KocurMaros/MicroMouse/FEIStyle/includes/glossary.tex

\newacronym{ToF}{ToF}{Time of Flight}
\newacronym{PWM}{PWM}{Pulse width modulation}
