KocurMaros/MicroMouse/RiadenieProjektu/includes/glossary.tex

\newacronym{sw}{SW}{Star Wars}
\newacronym{hw}{HW}{Halo Wars}
\newacronym{cdma}{CDMA}{Code Division Multiple Access}
\newacronym{gsm}{GSM}{Global System for Mobile communication}
\newacronym{ToF}{ToF}{Time of Flight}
\newacronym{PWM}{PWM}{Pulse width modulation}
