KocurMaros/MicroMouse/FEIStyle/example_paper.pdf

### SLOVENSKÁ TECHNICKÁ UNIVERZITA V BRATISLAVE

### FAKULTA ELEKTROTECHNIKY A INFORMATIKY

## MICRO MOUSE

## SEMINÁRNA PRÁCA

2024 Bc. Eduard Zelenay Bc. Erik Móčik Bc. Filip Lobpreis Bc. Jakub Močarník Bc. Maroš Kocúr Bc. Matúš Machata Bc. Timotej Polc

### SLOVENSKÁ TECHNICKÁ UNIVERZITA V BRATISLAVE

### FAKULTA ELEKTROTECHNIKY A INFORMATIKY

## MICRO MOUSE

## SEMINÁRNA PRÁCA

Študijný program: | Aplikovaná informatika
Predmet: | I–TP – Tímový projekt
Prednášajúci: | doc. Ing. Andrej Babinec, PhD.
Bratislava 2024 | Bc. Eduard Zelenay Bc. Erik Móčik Bc. Filip
Lobpreis Bc. Jakub Močarník Bc. Maroš Kocúr Bc. Matúš Machata Bc. Timotej Polc

## Obsah

ii

# Zoznam obrázkov a tabuliek

iii

# Zoznam skratiek

PWM Pulse width modulation

ToF Time of Flight

iv

# Zoznam algoritmov

v

# Zoznam výpisov

vi

# Úvod

Práca spočíva v navrhnutí, zostrojení a programovaní mobilného robota, ktorý dokáže autonómne prechádzať bludiskom. Študenti musia dodržať maximálne povolené rozmery

pre súťaž a vybrať vhodné typy senzorov, ktoré umožnia vypočítať polohu na navigáciu

robota v bludisku.
Úlohy:
1. Navrhnutie a výroba dizajnu robota.
2. Výber vhodných motorov a snímačov (napr. ToF (Time of Flight), motorový ovlá-

dač, gyroskop).

3. Programovanie riadenia robota a implementácia spôsobu lokalizácie v bludisku.
4. Otestovanie funkčnosti zvoleného riešenia

# 1 Hardware

Z hárdverovej stránky sme potrebovali v tomto projekte vytvoriť dosku plošných spojov (PCB - Printed Circuit Boards) a návrh držiakov motorov, gyroskopu a kolies,

ktorých výroba prebiehala pomocou 3D tlače.

## 1.1 Model

Kolesá a ozubené koliesko pre hriadeľ motora boli vytlačené v 3D tlačiarni s resinovou

náplňou FabPro 1000 Resin Cartridge Tough BLK. Na obrázkoch ?? a ?? môžeme vidieť

návrhy ozubeného kolieska pre hriadeľ a kolesa.

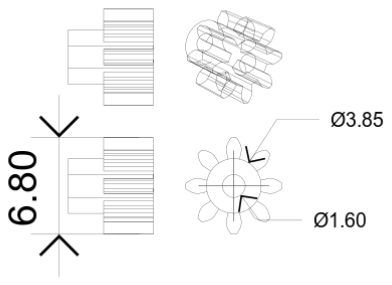
[picture p14: figure]

Obr. 1.1: UTechnický nákres prevodu motora

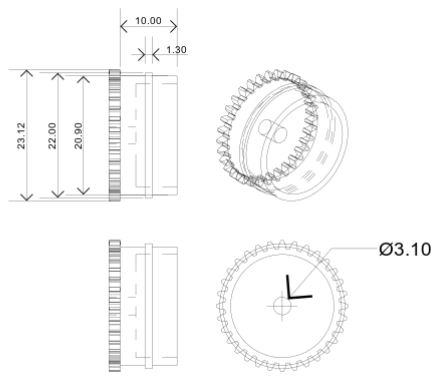
[picture p15: figure]

Obr. 1.2: Koleso s prevodovkou

## 1.2 Motory

Použité motory boli vybrané s ohľadom na ich výkonnosť a spoľahlivosť. Sú to jed-

nosmerné motory, vidieť ich môžeme na ?? a detaily o nich uvádzame nižšie:


Obr. 1.3: DC Mikromotor Faulhaber 1717T003SR

- Model: Faulhaber 1717 T
- Typ: 003 SR
- Max. točivý moment: 5.35 mNm
- Max. rýchlosť: 11000 rpm
- Odkaz na technický list: Technický list motora (https://www.faulhaber.com/fileadmin/Import/Media/EN_1717_SR_DFF.pdf)

## 1.3 Enkódery

Na monitorovanie polohy a otáčok motorov sme použili magnetické enkódery. Infor-

máciu o rotácií získavajú ako zmenu magnetického poľa. Enkóder obsahuje dva Hallove

články, ktoré merajú veľkosť magnetickej indukcie ako Hallovo napätie ako:

UH = hH

BIp
h

(1.1)

kde UH je Hallovo napätie, hH je Hallova konštanta, B je magnetická indukcia, Ip je po-

mocný prúd, h je hrúbka polovodičovej doštičky. Tieto Hallove články merajú magnetickú

indukciu v dvoch osiach na seba kolmých.

Enkóder obsahuje permanentný magnet pripevnený na jeho hriadeľ. Rotáciou hriadeľa

sa točí magnet, a teda aj smer magnetického poľa. Zmeny v oboch osiach sú prekonver-

tované cez AD prevodník na digitálne signály. Skrz trigonometrické funkcie je následne vypočítaný fázový posun medzi týmito signálmi. To je dôležité nielen kvôli výpočtu rotácie

hriadeľa, ale aj pre zistenie smeru rotácie.

Nižšie sú uvedené informácie o použitých enkóderoch ??:

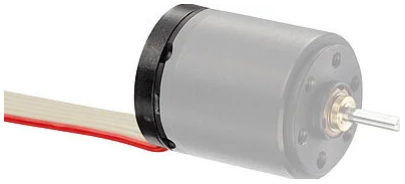
[picture p16: figure]

Obr. 1.4: Enkóder IEH2-4096

- Model: IEH2-4096
- Rozlíšenie: 4096
- Kanály: 2
- Odkaz na technický list: Technický list enkódera (https://www.faulhaber.com/fileadmin/Import/Media/EN_IEH2-4096_DFF.pdf)

## 1.4 Gyroskop

Na sledovanie orientácie a pohybu robota sme si zvolili MEMS gyroskop. Tie merajú

uhlovú rýchlosť prostredníctvom Coriolisovho efektu. Coriolisova sila je spôsobená inerciou

objektu v priamom pohybe, kolmo na smer pohybu objektu a jej výpočet je daný:

F⃗ = −2mΩ⃗
zx⃗v | (1.2)

MEMS Gyroskop obsahuje vybrujúce elementy na pružine. Keď sa gyroskop pohybuje

kapacitný senzor deteguje vibrácie, tie sa následne premenia na uhlové zrýchlenie.

Ďalej sú uvedené podrobnosti o použitom module ??:


Obr. 1.5: Gyroskop MPU9250

- Model: MPU9250
- Typ: Gyroskop, akcelerometer a magnetometer
- Komunikácia: I2C, SPI
- Odkaz na technický list: MPU9250 Technical Datasheet (https://www.invensense.com/products/motion-tracking/9-axis/mpu-9250/)

## 1.5 Laserový diaľkomer

Ako vzdialenostný senzor sme zvolili Time-of-Flight (doba trvania letu) laserový me-

rací modul poskytujúci presné meranie vzdialenosti bez ohľadu na farbu alebo odrazivosť

cieľa. Time-of-Flight senzory fungujú na báze merania času letu laserového lúča vyslaného

zo senzora, k objektu a naspäť. Vzdialenosť je z nameraného času vypočítaná podľa vzorca

na ??:

d =

c · t
2

(1.3)

kde d je vypočítaná vzdialenosť, c je rýchlosť svetla a t je doba letu lúča.

Modul môžeme vidieť na obrázku ??. Nižšie sú uvedené parametre senzora.

- Model: VL53L1X


Obr. 1.6: Vzdialenostný senzor VL53L1X

- Maximálna vzdialenosť: 400cm
- Frekvencia merania: nastaviteľná až do 50Hz
- Zorné pole: 27°
- Komunikácia: I2C
- Odkaz na technický list: Technický list laserového diaľkomera (https://www.st.com/resource/en/datasheet/vl53l1x.pdf)

Na meranie vzdialenosti sme využili štyri takéto moduly pripevnené na dosku vyosené

relatívne od dopredného smeru myši o 45° a 10°.

## 1.6 PCB

### 1.6.1 Komponenty

- Senzory ToF (VL53L1X): Prepojenie s ESP32 cez I2C rozhranie.
- Gyroskop s akcelerometrom (MPU9250): Prepojenie s ESP32 cez I2C rozhra-

nie.

- Driver na motor (TB6612FNG): Umiestnený blízko motorov, posiela PWM

signály motorom.

- MCU (ESP32): Centrálny riadiaci prvok PCB.
- Step-up menič na 5V: Zabezpečenie stabilných 5V pre logické obvody a enkodéry.
- Logic shifter: Prekladanie signálov medzi 3,3V a 5V úrovňami.

- Ochrana batérie: Meranie napätia batérie a prúdové ochrany.
- Batéria (Li-ion 1000mAh): Umiestnená na PCB s prístupnými napájacími ko-

nektormi a ochrannými obvodmi.

### 1.6.2 Proces tvorby PCB

- Návrh schémy

Vytvorili sme detailný návrh elektrickej schémy s prepojeniami všetkých komponen-

tov, pričom sme zabezpečili správne napäťové úrovne a prepojenia medzi jednotli-

vými časťami.

- Rozmiestnenie komponentov

Strategicky sme umiestnili všetky komponenty na PCB tak, aby boli minimalizované

rušenia a zohľadnené fyzické rozmery a montážne obmedzenia.

- Vedenie ciest
Navrhnli sme cesty (trasy) pre prepojenie komponentov, s dôrazom na minimalizáciu

kríženia ciest a optimalizáciu pre rušenie (napr. použitie samostatných zemných a

napájacích rovín).

- Napájanie a ochrany
Implementovali sme obvody na stabilizáciu napätia (3,3V a 5V), ochrany batérie, a

zabezpečili, aby boli všetky komponenty správne napájané a chránené.

Taktiež sme museli myslieť na nasledovné:

- Udržanie minimálnej dĺžky kritických signálových trás (I2C, PWM).
- Oddelenie silových a signálových ciest na PCB, aby sa minimalizovalo rušenie.
- Zabezpečenie dostatočnej kapacity a filtrácie na napájacích cestách.
- Implementácia ochranných obvodov pre batériu a citlivé komponenty.

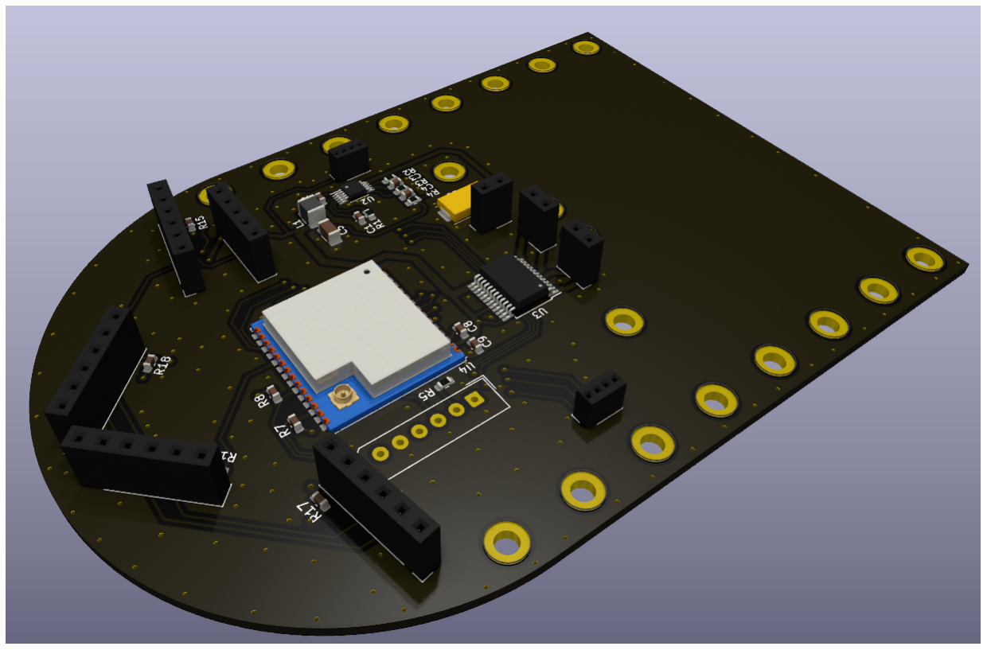
[picture p17: figure]

Obr. 1.7: Návrh PCB dosky použitej vo finálnej verzii.

## 1.7 CAD

Pri návrhu ako aj pri postupnom iterovaní sme zohľadňovali mnohé aspekty spojené

s procesom pri prototypizovaní. Mnohé verzie boli navrhnuté rovnako no v konečnom

dôsledku nám ich proces tlače zmenil a museli sme sa s tým vysporiadať, pretože presnosť

pri našom návrhu zohrávala kľúčovú úlohu. Pri tlači sme používali dva typy 3D tlače,

klasickú FDA no aj živicovú SLA tlač.

- 3D návrh kolies

Kolesá pre Micro Mouse boli navrhnuté na základe existujúcich modelov, ktoré po-

skytli osvedčený základ pre dizajn. Použitie osvedčených modelov umožnilo urýchliť návrhový proces a zaručilo, že výsledné kolesá budú spĺňať požadované špecifikácie.

- Výber modelu

Pre návrh kolies sme vybrali modely, ktoré sú už overené v praxi. Tento prístup

minimalizoval riziko návrhových chýb a zabezpečil, že kolesá budú mať vhodné

mechanické vlastnosti a správne rozmery.

- Návrh gumy na kolesá

Gumy na kolesá boli použité z existujúceho modelu, čo zabezpečilo optimálnu trak-

ciu a odolnosť. Tento krok eliminoval potrebu vlastného návrhu gumy a umožnil

nám sústrediť sa na integráciu kolies do celkového návrhu Micro Mouse.

- 3D návrh úchytov

Pre návrh úchytov sme využili iteratívny proces, ktorý umožnil presné prispôsobenie

vzdialeností kolies a ich optimálne umiestnenie na Micro Mouse.

- Iteratívny proces návrhu

Návrh úchytov prebiehal v niekoľkých iteráciách, pričom sme upravovali vzdialenosti

kolies a ich polohu, aby sme dosiahli najlepšiu možnú stabilitu a pohyblivosť Micro

Mouse. Tento proces zahŕňal testovanie rôznych konfigurácií a úpravou návrhu na

základe výsledkov týchto testov.

- Optimalizácia vzdialeností

Upravovanie vzdialeností kolies bolo kľúčové pre dosiahnutie optimálnej manévrova-

teľnosti. Iteratívne úpravy umožnili presné doladenie návrhu, čo viedlo k zlepšeniu

celkového výkonu Micro Mouse.

Návrh a výroba 3D komponentov pre Micro Mouse zahŕňala použitie existujúcich

modelov kolies a gumy, ako aj iteratívny návrh úchytov. Tento prístup umožnil efektívne

vytvorenie funkčných a spoľahlivých komponentov, ktoré prispievajú k optimálnemu vý-

konu Micro Mouse.


Obr. 1.8: Konečná verzia návrhu všetkých komponentov vyrábaných pomocou 3D tlače

usporiadaných na PCB.

# 2 Software

Na písanie kódu sme použili prostredie esp_idf verzie 4.4.7, ktoré sme vytvorili za pomoci ich repozitára [espGithub].

Postup na inicializáciu ESP IDF a následné spustenie projektu je nasledovný:

1. Stiahnutie ESP IDF z repozitára [espGithub] (My sme použili verziu 4.4.7).
2. Spustenie príkazu ./install.sh esp32 pre Linux. Tento príkaz stiahne a nainštaluje

všetky potrebne závislosti.

3. Exportovanie súboru . ./export.sh pre Linux. Tento príkaz nastaví všetky potrebne

premenne prostredia.

4. Zmeniť aktuálny adresár na náš projekt.
5. Spustiť príkaz idf.py build pre kompiláciu projektu.
6. Spustiť príkaz idf.py -P <PORT_NR> flash pre nahratie binárneho súboru do ESP32.

Pre tuto operáciu je potrebne mať pripojený počítač a misku cez UART.

7. Spustiť príkaz idf.py monitor pre sledovanie výstupu z ESP32.

Alternatívne spustenie je možné pomocou platformy Visual Studio Code s nainštalovaným rozšírením ESP-IDF [espIDF].

## 2.1 Senzory

### 2.1.1 VL53L1X

Pre snímanie vzdialenosti bola vytvorená knižnica na kalibráciu a vyčítavanie dát

zo senzora VL53L1X. Komunikácia prebieha prostredníctvom komunikačného protokolu

I

2C. Knižnica je nadstavbou nad voľne dostupným rozhraním od STMicroelectronics.

Na obrázku ?? je zobrazený princíp fungovania senzora využívajúceho metódu Time-of-

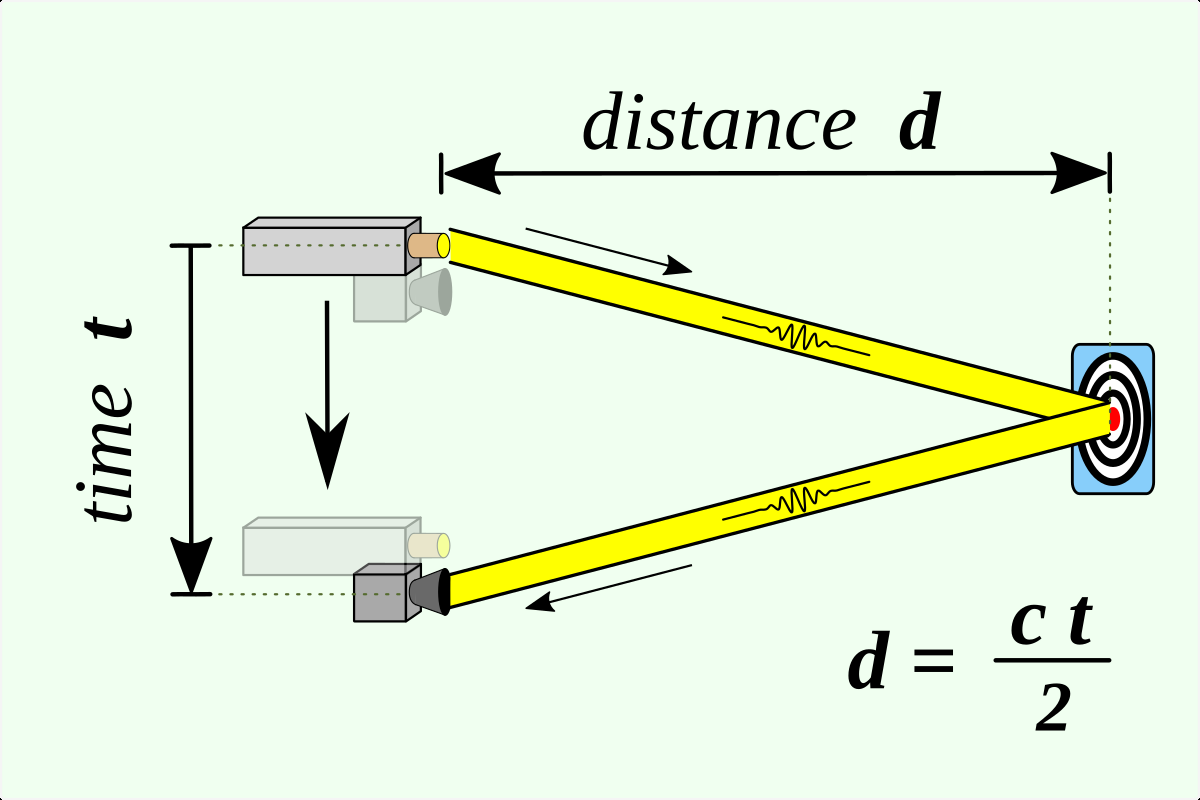
[picture p18: figure]

Obr. 2.1: Základný princíp ToF

Flight (ToF) pre meranie vzdialenosti. Zariadenie emituje svetelný signál, ktorý sa odrazi

od objektu a vráti späť k senzoru.

### 2.1.2 MPU9250

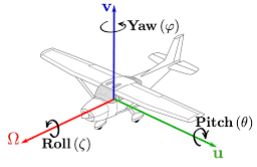
[picture p19: figure]

Obr. 2.2: Gyroskop s akcelerometrom MPU9250

V našom projekte sme použili senzor MPU9250, ktorý je trojosovým akcelerometrom

a gyroskopom. Tento senzor nám umožňuje získavať presné údaje o orientácii mikromyši v trojrozmernom priestore. Kľúčovou súčasťou spracovania dát z tohto senzoru je výpočet

Eulerových uhlov – roll, pitch a yaw. Tieto údaje sú neoceniteľné pre stabilizáciu a presné

navigačné manévre mikromyši, poskytujúc tak lepší prehľad o jej aktuálnom náklone a

orientácii.

### 2.1.3 IEH2-4096

V rámci nášho projektu sme implementovali impulzové čítače s inkrementálnymi en-

kodérmi IEH2-4096, ktoré sú pripevnené na motory. Tieto enkodéry generujú signál v

podobe elektrických impulzov v závislosti od uhlového pohybu motorov. Pre naše účely sme nastavili systém tak, aby generoval prerušenie po každej 1/8 otáčke motora.

Každý "tick"nám indikuje 1/8 otáčky motora, a pomocou softvéru potom prepočíta-

vame tieto hodnoty na požadované metrické jednotky (napríklad stupne alebo radiány).

Tento mechanizmus nám umožňuje presne sledovať a regulovať pohyb mikromyši, čo je

kritické pre presné navigačné a kontrolné úlohy v autonómnych aplikáciách.

## 2.2 Odometria

Pri počítaní polohy robota bola použítá odometria. Použili sme na to inkrementálny

enkóder ??, ktorý je pripojený na motor ??. Z enkóderov si získame aktuálnu polohu

robota cez základný vzťah:

∆xt = xt−1 + ∆st

- cos(ϕt−1 + ∆ϕt) | (2.1)

∆yt = yt−1 + ∆st

- sin(ϕt−1 + ∆ϕt) | (2.2)

,kde:

- ∆xt a ∆yt sú zmeny pozície robota v osiach x a y v čase t,
- xt−1 a yt−1 sú predchádzajúce pozície robota v osiach x a y,
- ∆st
je vzdialenosť, ktorú robot prešiel od posledného merania,
- ϕt−1 je predchádzajúci uhol orientácie robota,
- ∆ϕt
je zmena uhla orientácie robota získaná z gyroskopu.

Pre lepšie pochopenie odometrie a jej presnosti je dôležité zvážiť aj potenciálne chyby

z enkóderov a gyroskopu, ako aj spôsoby ich korekcie v softvérovom riešení robota.

## 2.3 PID regulátor motorov

Do motorov posielame ako akčný zásah signál PWM (Pulse width modulation). Tento

signál môže nadobúdať hodnoty od 0 po 1023. Zároveň musíme myslieť aj na prepäťovú

ochranu. Keď pošleme do motorov veľké zrýchlenie, tak sa stane, že sa program na čipe

zresetuje.

Aby sme ošetrili tieto situácie, sme pridali rozbehový člen v podobe rampového sig-

nálu, ktorý zabezpečí postupné zmeny žiadanej hodnoty namiesto skokových zmien. Na

riadenie motorov sme implementovali PID regulátor s Antiwindupom. Jeho obmedzenie je

nastavené zdola na 0 a zhora na 1023. Toto obmedzenie zdola je nastavené na 0 kvôli imple-

mentácii nastavenia smeru otáčania motorov. V prostredí ESP musíme dopredu nastaviť

smer otáčania motorov. Po jeho nastavení sa všetky hodnoty posielajú ako unsigned. Teda

ak by sme mu poslali zápornú hodnotu, tak by sa motor rozbehol nastaveným smerom.

Antiwindup zapojenie maximálnu rýchlosť obmedzuje na 1023.

Pre jednoduchosť ovládania sme nastavili regulátor tak, aby vstupná žiadaná hodnota

bol v milimetroch za sekundu. Regulátor si túto hodnotu prepočíta na PWM signál, ktorý pošle motorom. Spätné väzby sa získavajú z enkóderov a dopočítavajú sa na milimetre

za sekundu. Tieto hodnoty sa taktiež prepočítajú na PWM signál. Prepočet z milimetrov

za sekundu na PWM signál je závislý uskutočňovaný nasledujúcim výpočtom:

mmps = dπ IMPt IMPpri∆t
(2.3)

Rovnica ?? obsahuje parametre:

- d - Priemer kolesa,
- IMPt - Aktuálne impulzy z enkóderu,
- IMPpr - Impulzy z enkóderu za jednu otáčku (per rotation),
- i - Pomer prevodovky motora. Na našich motoroch je to prevod 32:8,
- ∆t - Časový interval od posledného merania

PWM =

mmps
MW SIMPpr

(2.4)

Rovnica ?? obsahuje parametre:

- mmps - Rýchlosť robota v milimetroch za sekundu vypocitanej v rovnici ??,
- MWS - Maximálna rýchlosť otacania kolies,
- IMPpr - Impulzy z enkóderu za jednu otáčku (per rotation).

## 2.4 Riadiaci algoritmus

Na obrázku ?? je znázornený tokový diagram, ktorý predstavuje algoritmus na roz-

hodovanie o pohybe v priestore. Tento diagram obsahuje niekoľko krokov a rozhodnutí:

1. Štart - Začiatočný bod algoritmu.
2. Slepá ulica? - Rozhodovací krok, kde sa algoritmus pýta, či sa pred myškou na-

chádza slepá ulica.

- Ak áno, nasleduje krok Otoč sa, čo znamená zmenu smeru o 180 stupňov.
- Ak nie, pokračuje ďalším rozhodnutím.
3. Je ľavá stena bližšie ako pravá? - Ďalšie rozhodovacie kritérium zvažujúce re-

latívne pozície stien.

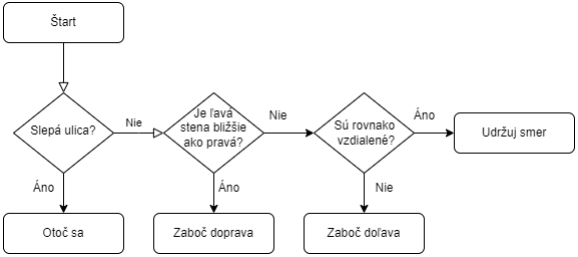
[picture p20: figure]

Obr. 2.3: UML diagram logiky algoritmu

- Ak áno, nasleduje krok Zaboč doprava.
- Ak nie, presmeruje sa na ďalší rozhodovací bod.
4. Sú rovnako vzdialené? - Rozhoduje, či sú obidve steny rovnako vzdialené od

myšky.

- Ak áno, nasleduje krok Zaboč doľava.
- Ak nie, vykoná sa krok Udržuj smer, čo znamená pokračovanie v súčasnom

smere bez zmeny.

## 2.5 Upresnenie implementacie

Miska funguje na principe reaktivnej navigacie. V pristupe kombinujeme 2 metody.

Jedna je Braitenbergov pohon typu fear a PID regulator. Nase zariadnie pouziva 4 ToF

snimace:

- ToF1 - Snimac na lavej strane snimajuci smer vpred,
- ToF2 - Snimac na lavej strane snimajuci smer valavo pod uhlom 45 stupnov, tak

aby snimali dalsiu bunku,

- ToF3 - Snimac na prave strane snimajuci smer vpravo pod uhlom 45 stupnov, tak

aby snimali dalsiu bunku,

- ToF4 - Snimac na prave strane snimajuci smer vpred

Kedze bludisko je splet uliciek, o ktorych nevieme kadial smeruju tak nam snimace

mozu vratit rozne velke hodnoty. Z tohto dovodu nam mozu snimace vracat velek aj

male hodnoty. Aby sme spravili z nepredvidatelneho prostredia predvidatelne, tak sme

vzdialenosti snimacov 1 a 4 obmedzili na 20 centimetrov. Toto obmedzenie vychadzalo z

exprimentalnych merani v bludisku o velkosti uliciek 22.5 centimetra.

Algoritmus funguje nasledovne:

1. Zistenie rozdielu ToF1 a ToF4.
2. Dopocitanie akcneho zasahu na z PID zo zisteneho rozdielu.
3. Tocimesa na zaklade znamienka akcneho zasahu.
4. Otacanie sa ovplyvnuje na zaklade vzdialenosti ToF2 a ToF3.

## 2.6 UDP Komunikácia

### 2.6.1 Client

Klientom v našom prípade je ESP32, ktorý sa používa v PCB mikromyši. Toto za-

riadenie je zodpovedné za zber údajov o stave a správaní mikromyši a ich odosielanie na

server. Komunikácia s serverom prebieha prostredníctvom UDP protokolu, čo umožňuje

rýchly a efektívny prenos dát.

### 2.6.2 Server

Na strane servera sme použili vývojové prostredie Qt Creator s programovacím ja-

zykom C++ na implementáciu serverovej časti, ktorá prijíma dáta od klienta. Server je integrovaný s mini HMI (Human-Machine Interface) aplikáciou, ktorá umožňuje real-time

vizualizáciu dát prostredníctvom grafov a poskytuje užívateľské rozhranie pre sledovanie

a ladenie správania mikromyši.

HMI aplikácia je kľúčovým nástrojom pre efektívne diagnostikovanie a optimalizáciu

výkonu autonómnej mikromyši. ??

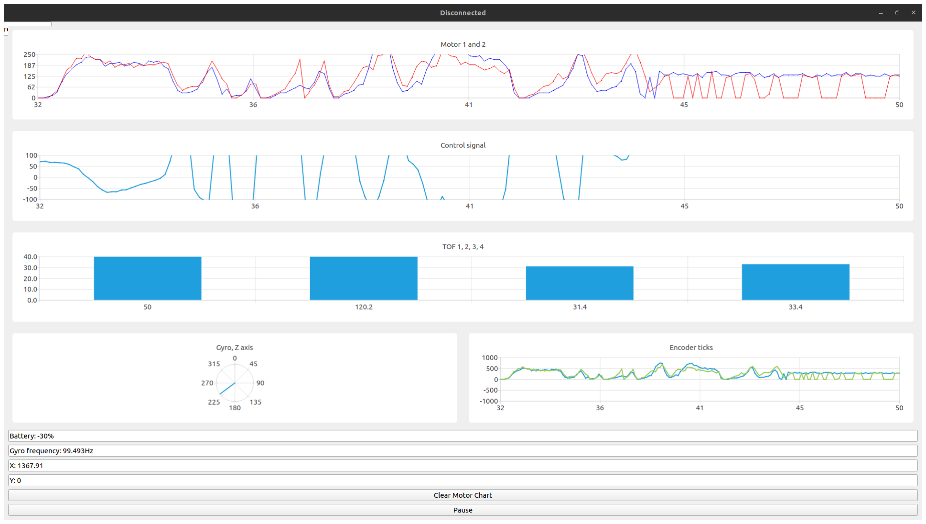
[picture p21: figure]

Obr. 2.4: Používateľské rozhranie HMI aplikácie

# Záver

Na tomto zadaní sme sa naučili komunikovať a riešiť problémy ako tím.

Na záver môžeme konštatovať, že úlohy projektu MicroMouse boli úspešne splnené.

Plne sme využili potenciál celého tímu a maximálne sme sa snažili využiť všetky nami

zadefinované senzory. Optimalizáciou softvéru sme dosiahli, že robot dokázal prechádzať

úzkymi uličkami bez nárazov, čo výrazne prispelo k jeho celkovej efektivite a presnosti.

Počas projektu sme však narazili na problémy s pohonom, konkrétne so zablokova-

ním prevodovky, čo spôsobovalo nepresnosť v odometrii. Tieto problémy nám znemožnili

využitie odometrie na lokalizáciu robota.

V druhej verzii projektu sa zameriame na odstránenie týchto nedostatkov, aby sme

mohli plne využiť odometriu na presnú lokalizáciu robota. A taktiež by sme chceli upraviť

hardware, keďže máme k dispozícii presne rozmery senzorov a motorov a odladili sme

chyby týkajúce sa hardware na prvej verzii, čo by mohlo pomôcť robotu pohybovať sa

plynulejšie a pomôže to taktiež s váhou robota. Na nasledujúce hardwarove úpravy by

sme vyladili regulátory a robot sa bude správať rovnako ako v prvej verzii.

Veríme, že tieto skúsenosti a získané poznatky nám umožnia pokračovať v ďalšom

vývoji a dosiahnuť ešte lepšie výsledky v budúcich verziách MicroMouse.

# Prílohy

# A Štruktúra elektronického nosiča

# B Algoritmus

# C Výpis sublime
