KocurMaros/MicroMouse/Datasheets/angle_tofs.png

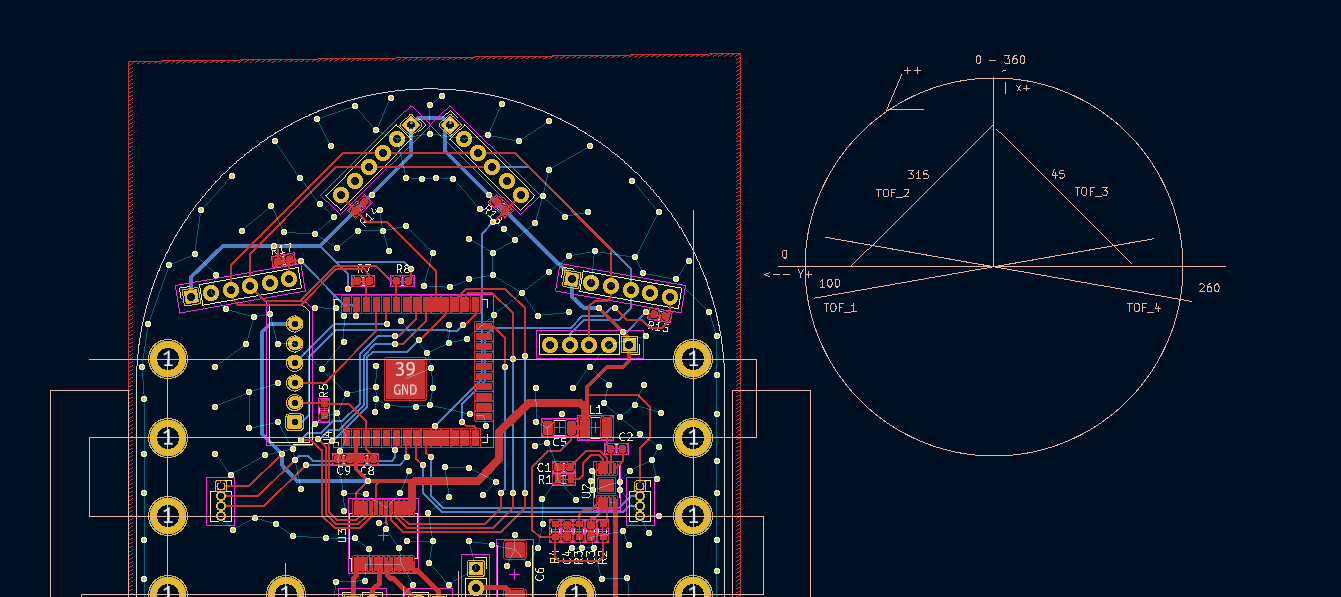
Datasheets/angle_tofs.png
