KocurMaros/MicroMouse/Datasheets/dist_from_center.png

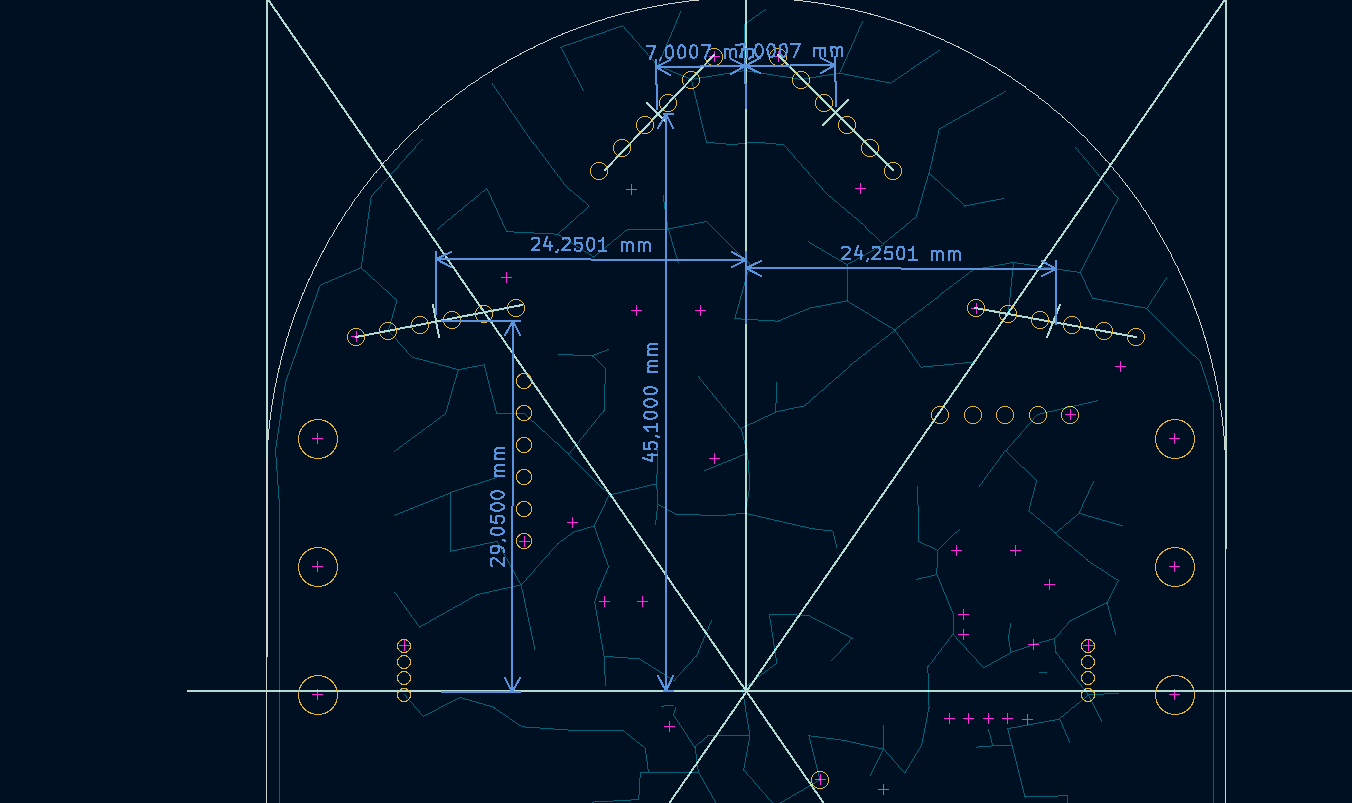
Datasheets/dist_from_center.png
