KocurMaros/MicroMouse/3D/main_board_v2.step

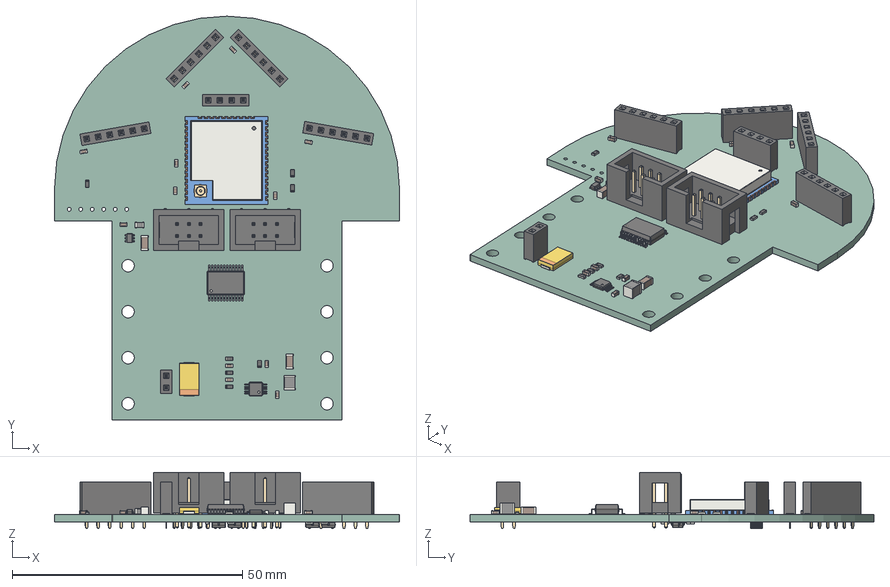
[picture p24: CAD file, 2024-11-08]
3D/main_board_v2.step
75.0 x 87.8 x 12.2 mm
PinSocket_1x06_P254mm_Vertical x 4
R_0603_1608Metric x 15
C_0603_1608Metric x 12
CP_EIA_7343_15_Kemet_W
PinSocket_1x02_P254mm_Vertical
C_1206_3216Metric x 2
ESP32-WROOM-32U
MSOP_10_1EP_3x3mm_P05mm
IDC_Header_2x03_P254mm_Vertical x 2
SOT_363_SC_70_6
L_1210_3225Metric
PinSocket_1x04_P254mm_Vertical
L_0805_2012Metric
SSOP_24_53x82mm_P065mm
SOT_23 x 4
main_board_PCB
