KocurMaros/MicroMouse/3D/1717T_SR.stp

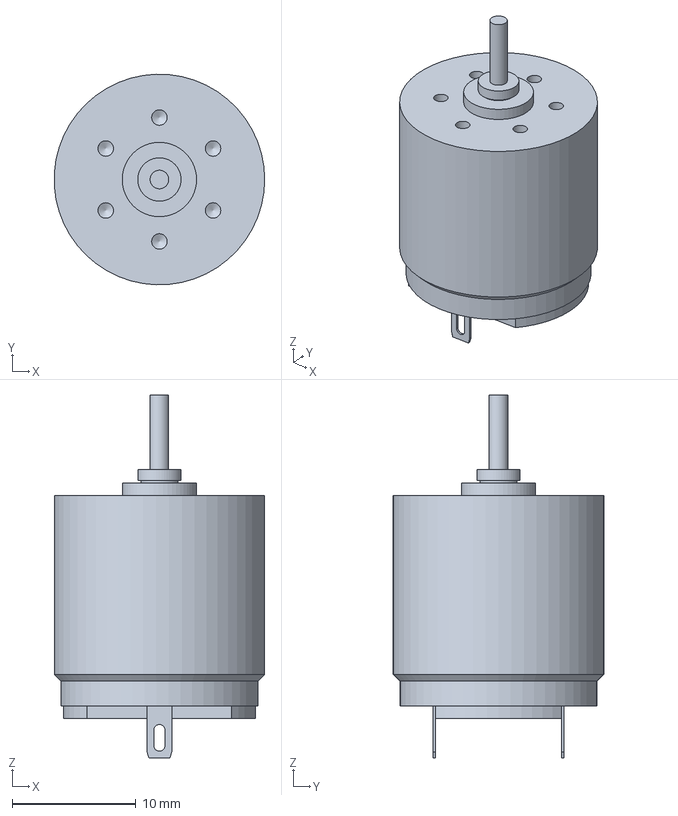
[picture p26: CAD file, 2024-05-28]
3D/1717T_SR.stp
17.0 x 17.0 x 29.3 mm
