KocurMaros/MicroMouse/3D/Side_wall_L.stp

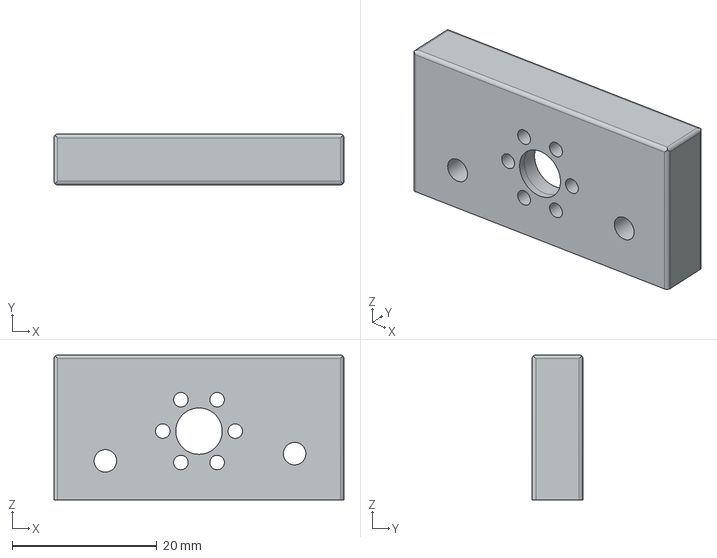
[picture p27: CAD file, 2024-05-28]
3D/Side_wall_L.stp
40.0 x 7.00 x 20.0 mm
