KocurMaros/MicroMouse/3D/Mount.stp

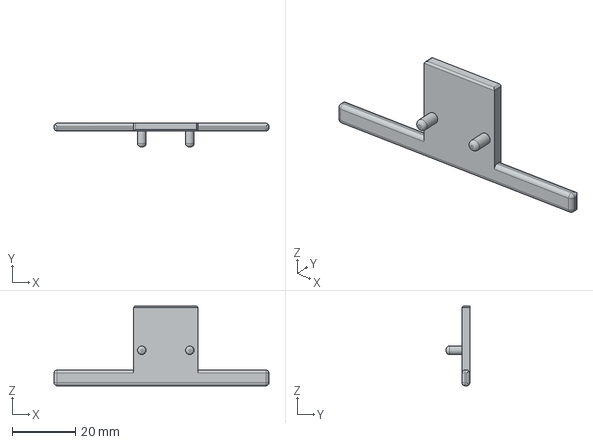
[picture p28: CAD file, 2024-05-28]
3D/Mount.stp
68.0 x 7.50 x 25.2 mm
