KocurMaros/MicroMouse/3D/motor_gear2.stp

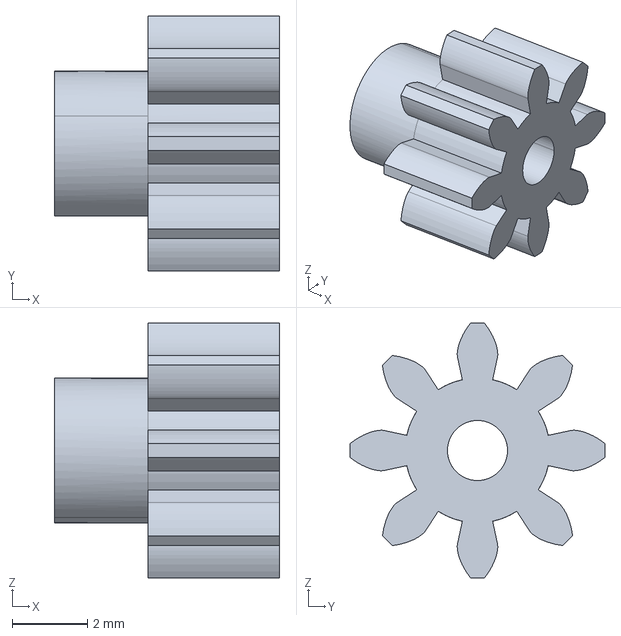
[picture p29: CAD file, 2024-05-28]
3D/motor_gear2.stp
6.00 x 6.79 x 6.79 mm
