KocurMaros/MicroMouse/3D/wheel_w_gear_2.stp

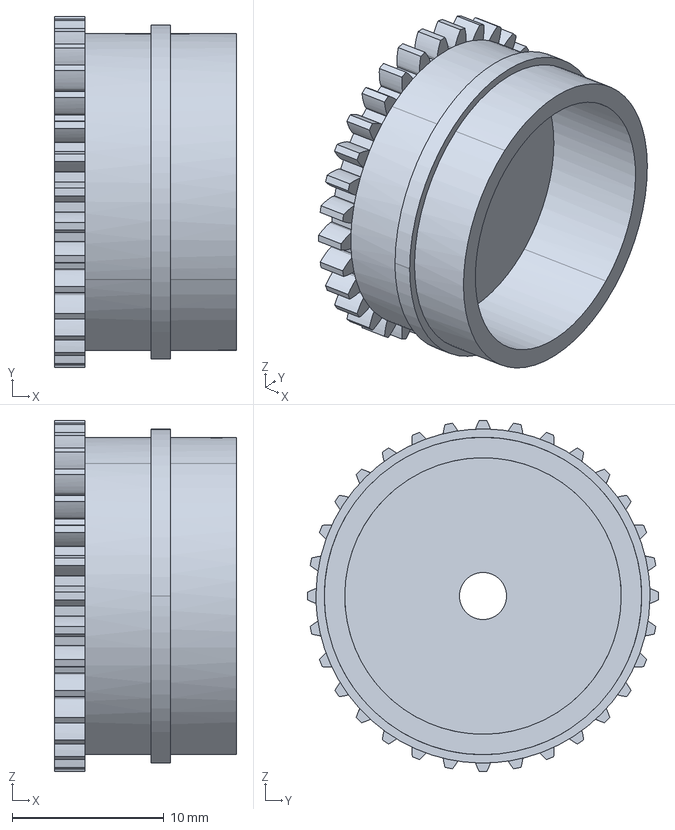
[picture p30: CAD file, 2024-05-28]
3D/wheel_w_gear_2.stp
12.0 x 23.1 x 23.1 mm
