KocurMaros/MicroMouse/3D/wheel_without_gear.stp

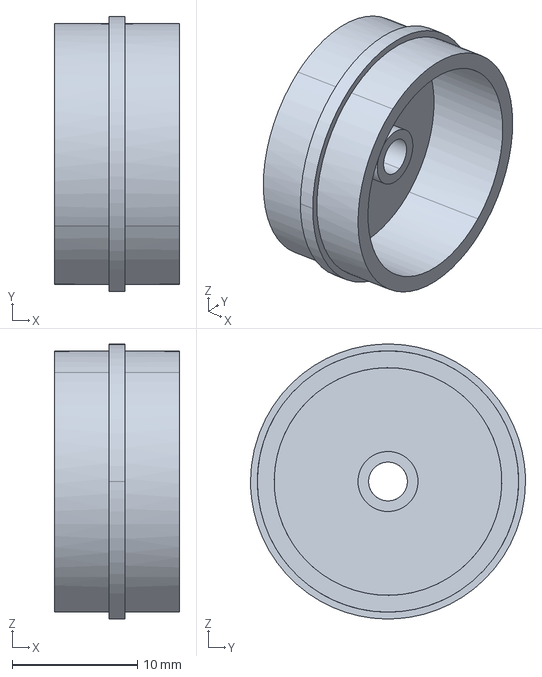
[picture p31: CAD file, 2024-05-28]
3D/wheel_without_gear.stp
10.0 x 22.0 x 22.0 mm
