KocurMaros/MicroMouse/3D/motor_gear.obj

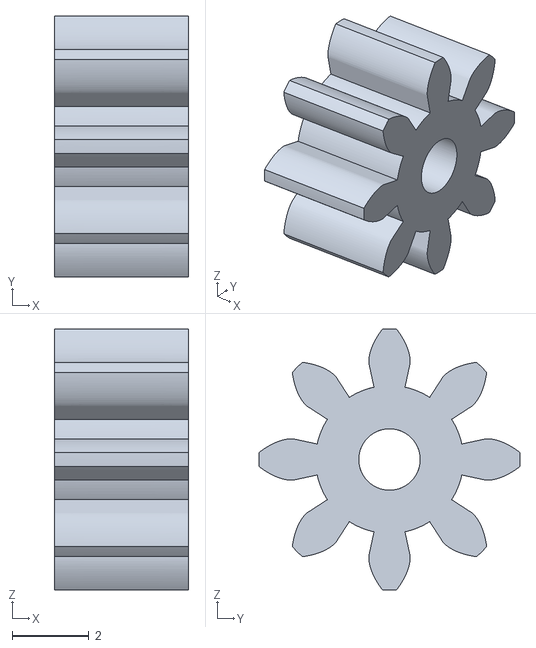
[picture p32: CAD file, 2024-03-11]
3D/motor_gear.obj
3.50 x 6.80 x 6.80
