KocurMaros/MicroMouse/3D/wheel_w_gear.obj

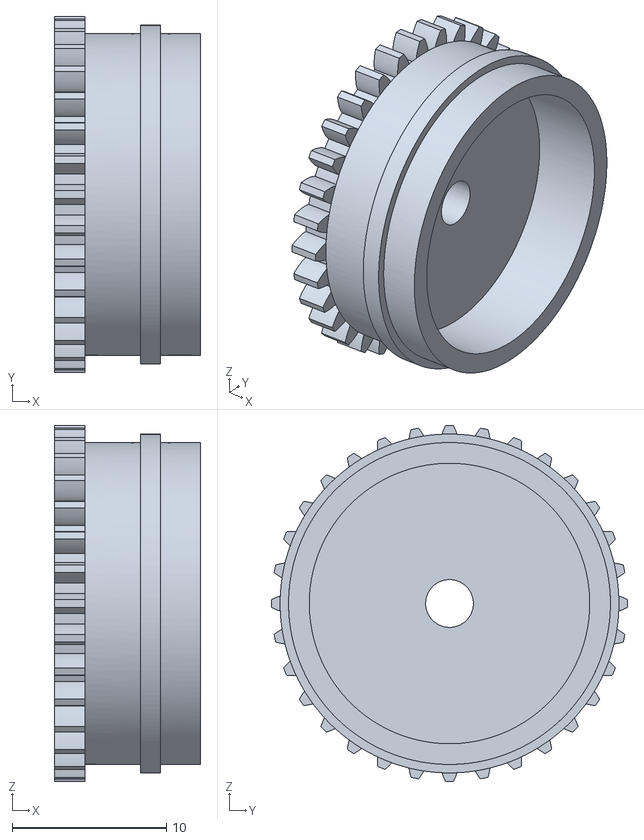
[picture p33: CAD file, 2024-03-11]
3D/wheel_w_gear.obj
9.50 x 23.1 x 23.1
