KocurMaros/MicroMouse/3D/main_board.step

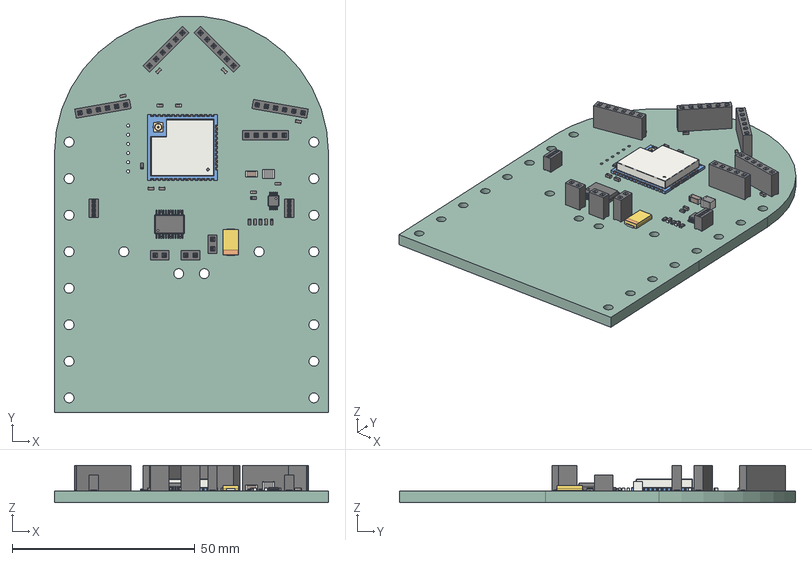
[picture p34: CAD file, 2024-02-29, an earlier design]
3D/main_board.step
75.0 x 108.4 x 10.2 mm
PinSocket_1x06_P254mm_Vertical x 4
R_0603_1608Metric x 5
C_0603_1608Metric x 12
CP_EIA_7343_15_Kemet_W
PinSocket_1x02_P254mm_Vertical x 3
ESP32-WROOM-32U
MSOP_10_1EP_3x3mm_P05mm
PinSocket_1x04_P127mm_Vertical x 2
L_1210_3225Metric
SSOP_24_53x82mm_P065mm
PinSocket_1x05_P254mm_Vertical
C_1206_3216Metric
main_board_PCB
