KocurMaros/MicroMouse/(list of files, cad)

Other CAD files:
3D/Side_wall_R.stp
3D/Mount.stl
3D/Side_wall_L.stl
3D/Side_wall_R.stl
3D/main_board.stl
