KocurMaros/MicroMouse/RiadenieProjektu/tutorial.pdf

Tutorial k písaniu zavere ´ | cnˇ ych pr ´ | ac pre ´ | sablonu ˇ

# FEIstyle v 1.2c

22. jula 2014 ´
1 Pouzitie ˇ | sablony ˇ
Sablona je defaultne nastaven ˇ | a pre p ´ | ísanie zavere ´ | cnˇ ych pre pre FEI STU v Bratislave ´
pre odbor Aplikovana informatika. ´

## 2 Príklad pouzitia ˇ sablony ˇ

\documentclass[bp]{FEIstyle}

\FEIauthor{Michal Liziˇ ciar ˇ | }
\FEItitle{Anonymizacia internetov ´ | eho pr ´ | ístupu}
\FEItitleEn{Anonymization of internet access} \FEIregNr{FEI-5382-5982}
\FEIsupervisor{Mgr. Ing. Matu´s J ˇ okay, PhD. ´ | }

\begin{document}
\FEIpdfInfo
\FEIcover
\FEItitlePage
\FEIassignment{includes/assignment.jpeg}
\FEIabstract{includes/abstract}{anonymizacia, identifik ´ | acia pou ´ | zˇívatel’a, zasuvn ´ | y mo- ´
dul, Mozilla Firefox, internet}
\FEIabstractEn{includes/abstractEN}{anonymization, identification of user, plugin, Mozilla Firefox, internet}
\FEIdeclaration{includes/declaration}
\FEIthanks{}
\FEIcontent
\FEIlistOfFiguresAndTables \FEIlistOfAbbreviationsAndSymbols{includes/AbbreviationsAndSymbols} \FEIlistOfAlgorithms
\FEIintroduction{includes/introduction}
\FEIcore{includes/core}

1

\FEIconclusion{includes/conclusion} \FEIbibliography{includes/bibliography}{FEIstyle} \FEIlistOfAppendix
\FEIappendix{Strukt ˇ | ura elektronick ´ | eho nosi ´ | caˇ }{includes/prilohaA}
\FEIappendix{Algoritmus}{includes/prilohaB}
\end{document}

## 3 Moznosti ˇ sablony ˇ

Argumenty sablony: ˇ

bp - bakalarska pr ´ | aca ´
dp – diplomova pr ´ | aca ´

article – stˇ yl article (default) ´
book – stˇ yl book ´
en – sablona p ˇ | ísana v anglickom jazyku ´
m - (muz) sklonovanie textu v slovenskom vyhl ˇ | asen ´ | í
z - (zena) sklonovanie textu v slovenskom vyhl ˇ | asen ´ | í
(default: dvojtvar (a))

windows1250 - kodovanie textu windows1250 (default) ´ utf8 - kodovanie textu utf8 ´

4 Globalne premenn ´ | é

\FEIauthor{meno}
- definuje autora zavere ´ | cnej pr ˇ | ace ´

\FEIschool{nazov skoly}
\FEIschoolEn{nazov skoly (anglicky)}
- definuje nazov ´ | skoly ˇ
default: Slovenska technick ´ | a univerzita v Bratislave ´
default: Slovak University of Technology in Bratislava

\FEItitle{nazov prace}
\FEItitleEn{nazov prace (anglicky)}
- definuje nazov pr ´ ace ´

\FEIfaculty{nazov fakulty} \FEIfacultyEn{nazov fakulty(anglicky)}

2

- definuje nazov fakulty ´
default: Fakulta elektrotechniky a informatiky
default: Faculty of Electrical Engineering and Information Technology

\FEIregNr{registracnˇ é cˇíslo}
- definuje registracne ˇ cˇíslo prace ´

\FEIdate{day}{month}{year}
- definuje datum vytvorenia pr ´ | ace ´
default: aktualny d ´ | atum ´
\FEIstudyProgramme{nazov ´ | studijn ˇ | eho programu ´ | }
\FEIstudyProgrammeEn{nazov ´ | studijn ˇ | eho programu(anglicky) ´ | }
- definuje nazov ´ | studijn ˇ | eho programu ´
default: Aplikovana informatika ´
default: Applied Informatics
\FEIstudyFieldNumber{cˇíslo studijn ˇ | eho odboru ´ | }
- definuje cˇíslo studijn ˇ | eho odboru ´
default: 2511
\FEIstudyField{nazov ´ | studijn ˇ | eho odboru ´ | }
\FEIstudyFieldEn{nazov ´ | studijn ˇ | eho odboru(anglicky) ´ | }
- definuje nazov ´ | studijn ˇ | eho odboru ´
default: 9.2.9 Aplikovana informatika ´
default: 9.2.9 Applied Informatics
\FEItrainingWorkplace{nazov ´ | skoliaceho pracoviska ˇ | }
\FEItrainingWorkplaceEn{nazov ´ | skoliaceho pracoviskan ˇ | azov ´ | skoliaceho pracoviska ˇ | }
- definuje nazov ´ | skoliaceho pracoviska ˇ
default: Ustav informatiky a matematiky ´
default: Institute of Computer Science and Mathematics

\FEIsupervisor{meno}
- definuje meno veduceho z ´ | avere ´ | cnej pr ˇ | ace ´

\FEIconsultant{meno}
- definuje meno konzultanta

\FEIplace{mesto}
- definuje miesto písania prace ´ default: Bratislava

3

## 5 Funkcie sablony ˇ

\FEIcover
- vytvorí obal zavere ´ | cnej pr ˇ | ace ´

\FEItitlePage
- vytvorí titulnu stranu z ´ | avere ´ | cnej pr ˇ | ace ´

\FEIdeclaration{[subor]}
- vytvorí vyhlasanie autora pr ´ | ace. Pri anglickom jazyku je povinn ´ | y extern ´ | y s ´ ubor. ´
default: defaultny text v slovenskom jazyku, mo ´ | znost ˇ | ’ zmenit’ text

\FEIthanks{[subor]}
- vytvorí pod’akovanie. Pri anglickom jazyku je povinny extern ´ | y s ´ ubor. ´
default: defaultny text v slovenskom jazyku, mo ´ | znost ˇ | ’ zmenit’ text

\FEIassignment{subor}
- vlozˇí obrazok zadania zavere ´ | cnej pr ˇ | ace ´

\FEIabstract{subor}{klucove slova}
\FEIabstractEn{subor}{klucove slova}
- vlozˇí abstrak zavere ´ | cnej pr ˇ | ace. Vstupom je extern ´ | y s ´ ubor a kl ´ | ’ućov ˇ e slov ´ | a abstraktu. ´

\FEIcontent
- vlozˇí obsah

\FEIlistOfTables
- vlozˇí zoznam tabuliek

\FEIlistOfFigures
- vlozˇí zoznam obrazkov ´

\FEIlistOfFiguresAndTables
- vlozˇí zoznam obrazkov a tabuliek ´

\FEIlistOfAbbreviations{subor}
- vlozˇí zoznam skratiek z externeho s ´ uboru ´

\FEIlistOfSymbols{subor}
- vlozˇí zoznam symbolov z externeho s ´ uboru ´

\FEIlistOfAbbreviationsAndSymbols{subor}
- vlozˇí zoznam skratiek a symbolov z externeho s ´ uboru ´

\FEIlistOfAlgorithms
- vlozˇí zoznam algoritmov

4

\FEIintroduction{subor}
- vlozˇí uvod z extern ´ | eho s ´ | uboru ´

\FEIcore{subor}
- vlozˇí jadro prace z extern ´ | eho s ´ | uboru ´

\FEIconclusion{subor}
- vlozˇí zaver pr ´ | ace z extern ´ | eho s ´ | uboru ´

\FEIresume{subor}
- vlozˇí resume z extern ´ | eho s ´ | uboru (pri pr ´ | acach p ´ | ísanych po anglicky) ´

\FEIbibliography{subor}{subor stylu}
- vlozˇí literaturu z extern ´ | eho s ´ | uboru, ´ | stˇ yl pre ´ | sablonu je definovan ˇ | y vo FEIstyle.bst ´

\FEIlistOfAppendix
- vlozˇí zoznam príloh

\FEIappendix{nazov}{subor}
- vlozˇí prílohu do prace. Nazov: text je uveden ´ | y v obsahu a v nadpise pr ´ | ílohy. Subor ´
definuje cestu k externemu s ´ | uboru. ´

\FEIpdfInfo
- vyplní hlavicku PDF dokumentu z preddefinovan ˇ | ych ´ | udajov (n ´ | azov pr ´ | ace, autor, ´
skola, fakulta) ˇ

5
