KocurMaros/MicroMouse/(threads)

Thread 1 (2024-02-28):

Sensor GY-VL53L0X I2C

KocurMaros, 2024-02-28:
Write driver for sensor GY-VL53L0X I2C, to read distance from 4 sensors.
SDA = GPIO21
SCL = GPIO22
xSHUT1 = GPIO23
xSHUT2 = GPIO05
xSHUT3 = GPIO25
xSHUT4 = GPIO12

Closed 2024-04-19.

Thread 2 (2024-02-28):

Motor driver and regulator

KocurMaros, 2024-02-28:
Write driver for motor driver and create speed controller.
Motor driver: TB6612FNG
MotorA:
Direction of rotation (Log.1/0):
    - GPIO18 CW
    - GPIO19 CCW
Speed(PWM):
    - GPIO17
MotorB:
Direction of rotation (Log.1/0):
    - GPIO16 CW
    - GPIO04 CCW
Speed(PWM):
    - GPIO02
Incremental encoder (interrupts):
MotorA:
    - GPIO34 ChannelA
    - GPIO33 ChannelB
MotorB:
    - GPIO35 ChannelA
    - GPIO32 ChannelB
https://www.faulhaber.com/fileadmin/Import/Media/EN_1717_SR_DFF.pdf
https://www.faulhaber.com/fileadmin/Import/Media/EN_IEH2-4096_DFF.pdf

Fildo7525, 2024-05-13:
Review the code to be merged

Closed 2024-05-30.

Thread 4 (2024-02-28):

3D model for motor base

KocurMaros, 2024-02-28:
CAD 3D model for holding motor and wheels according to PCB design.
Front wheels slightly lower than rear.
Try as light as possible

Thread 6 (2024-02-28):

3D CAD wheels

KocurMaros, 2024-02-28:
create 3D model of disk with gearbox [1:4~6], with used tires.

Probably:
https://www.peckamodel.sk/ksm538-pn-racing-mini-z-ks-m-compound-rcp-low-profile-slick-8-5mm-tire-medium-2pc
