KocurMaros/MicroMouse/code/esp_code/components/driver_tof/core/inc/vl53l1_api_core.h

/*
* Copyright (c) 2017, STMicroelectronics - All Rights Reserved
*
* This file is part of VL53L1 Core and is dual licensed,
* either 'STMicroelectronics
* Proprietary license'
* or 'BSD 3-clause "New" or "Revised" License' , at your option.
*
********************************************************************************
*
* 'STMicroelectronics Proprietary license'
*
********************************************************************************
*
* License terms: STMicroelectronics Proprietary in accordance with licensing
* terms at www.st.com/sla0081
*
* STMicroelectronics confidential
* Reproduction and Communication of this document is strictly prohibited unless
* specifically authorized in writing by STMicroelectronics.
*
*
********************************************************************************
*
* Alternatively, VL53L1 Core may be distributed under the terms of
* 'BSD 3-clause "New" or "Revised" License', in which case the following
* provisions apply instead of the ones mentioned above :
*
********************************************************************************
*
* License terms: BSD 3-clause "New" or "Revised" License.
*
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
* 3. Neither the name of the copyright holder nor the names of its contributors
* may be used to endorse or promote products derived from this software
* without specific prior written permission.
*
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
*
********************************************************************************
*
*/

/**
 * @file  vl53l1_api_core.h
 *
 * @brief EwokPlus25 low level API function definitions
 */

#ifndef _VL53L1_API_CORE_H_
#define _VL53L1_API_CORE_H_

#include "vl53l1_platform.h"

#ifdef __cplusplus
extern "C" {
#endif


/**
 * @brief Get LL Driver version information
 *
 * @param[in]   Dev       : Device handle
 * @param[out]  pversion  : pointer to VL53L1_ll_version_t
 *
 * @return  VL53L1_ERROR_NONE     Success
 */

#ifdef VL53L1_DEBUG
VL53L1_Error VL53L1_get_version(VL53L1_DEV Dev, VL53L1_ll_version_t *pversion);

/**
 * @brief Gets Device Firmware version
 *
 * @param[in]   Dev           : Device handle
 * @param[out]  pfw_version   : pointer to uint16_t FW version
 *
 * @return  VL53L1_ERROR_NONE     Success
 */

VL53L1_Error VL53L1_get_device_firmware_version(VL53L1_DEV Dev, uint16_t *pfw_version);
#endif


/**
 * @brief Initialises pdev structure and optionally read the
 *        part to part information form he device G02 registers
 *
 * Important: VL53L1_platform_initialise() *must* called before calling
 * this function
 *
 * @param[in]   Dev           : Device handle
 * @param[out]  read_p2p_data : if > 0 then reads and caches P2P data
 *
 * @return  VL53L1_ERROR_NONE     Success
 */

VL53L1_Error VL53L1_data_init(VL53L1_DEV Dev, uint8_t read_p2p_data);


/**
 * @brief  For C-API one time initialization only reads device
 *         G02 registers containing data copied from NVM
 *
 *  Contains the key NVM data e.g identification info
 *  fast oscillator freq, max trim and laser safety info
 *
 *  Function all only be called after the device has finished booting
 *
 * @param[in]   Dev           : Device handle
 *
 * @return  VL53L1_ERROR_NONE     Success
 */

VL53L1_Error VL53L1_read_p2p_data(VL53L1_DEV Dev);


/**
 * @brief Performs device software reset and then waits for  the firmware
 *        to finish booting
 *
 * @param[in]   Dev           : Device handle
 *
 * @return  VL53L1_ERROR_NONE     Success
 * @return  "Other error code"    See ::VL53L1_Error
 */

VL53L1_Error VL53L1_software_reset(VL53L1_DEV Dev);


/**
 * @brief  Sets the customer part to part data
 *
 * Important: does **not** apply the settings to the device.
 * Updates the following structures in the device structure
 *
 * Just an internal memcpy to
 *
 *
 * @param[in]   Dev             : Device handle
 * @param[in]   pcal_data       : pointer to VL53L1_calibration_data_t
 *
 * @return  VL53L1_ERROR_NONE     Success
 * @return  "Other error code"    See ::VL53L1_Error
 */

VL53L1_Error VL53L1_set_part_to_part_data(VL53L1_DEV Dev, VL53L1_calibration_data_t *pcal_data);


/**
 * @brief  Gets the customer part to part data
 *
 * Just an internal memory copy
 *
 * @param[in]   Dev             : Device handle
 * @param[out]  pcal_data       : pointer to VL53L1_calibration_data_t
 *
 *
 * @return  VL53L1_ERROR_NONE     Success
 * @return  "Other error code"    See ::VL53L1_Error
 */

VL53L1_Error VL53L1_get_part_to_part_data(VL53L1_DEV Dev, VL53L1_calibration_data_t *pcal_data);


/**
 * @brief  Gets the tuning parm part to part data
 *
 * Just an internal copy
 *
 * @param[in]   Dev             : Device handle
 * @param[out]  ptun_data       : pointer to VL53L1_tuning_parameters_t
 *
 *
 * @return  VL53L1_ERROR_NONE     Success
 * @return  "Other error code"    See ::VL53L1_Error
 */

#ifdef VL53L1_DEBUG
VL53L1_Error VL53L1_get_tuning_debug_data(VL53L1_DEV Dev, VL53L1_tuning_parameters_t *ptun_data);
#endif


/**
 * @brief  Sets the inter measurement period in the VL53L1_timing_config_t structure
 *
 * Uses the pdev->dbg_results.result__osc_calibrate_val value convert from [ms]
 *
 * @param[in]   Dev                         : Device handle
 * @param[in]   inter_measurement_period_ms : requested inter measurement period in [ms]
 *
 * @return  VL53L1_ERROR_NONE     Success
 * @return  "Other error code"    See ::VL53L1_Error
 */

VL53L1_Error VL53L1_set_inter_measurement_period_ms(VL53L1_DEV Dev, uint32_t inter_measurement_period_ms);


/**
 * @brief  Gets inter measurement period from the VL53L1_timing_config_t structure
 *
 * Uses the pdev->dbg_results.result__osc_calibrate_val value convert into [ms]
 *
 * @param[in]   Dev                           : Device handle
 * @param[out]  pinter_measurement_period_ms  : current inter measurement period in [ms]
 *
 * @return  VL53L1_ERROR_NONE     Success
 * @return  "Other error code"    See ::VL53L1_Error
 */

VL53L1_Error VL53L1_get_inter_measurement_period_ms(VL53L1_DEV Dev, uint32_t *pinter_measurement_period_ms);


/**
 * @brief  Sets the phasecal, mode mitigation and ranging timeouts
 *         in the VL53L1_timing_config_t structure
 *
 * Uses the pdev->stat_nvm.osc_measured__fast_osc__frequency value convert from [us]
 *
 * @param[in]   Dev                         : Device handle
 * @param[in]   phasecal_config_timeout_us  : requested Phase Cal Timeout e.g. 1000us
 * @param[in]   mm_config_timeout_us        : requested MM Timeout e.g. 2000us
 * @param[in]   range_config_timeout_us     : requested Ranging Timeout e.g 13000us
 *
 * @return  VL53L1_ERROR_NONE     Success
 * @return  "Other error code"    See ::VL53L1_Error
 */

VL53L1_Error VL53L1_set_timeouts_us(VL53L1_DEV Dev, uint32_t phasecal_config_timeout_us, uint32_t mm_config_timeout_us, uint32_t range_config_timeout_us);


/**
 * @brief  Gets the phasecal, mode mitigation and ranging timeouts
 *         for the VL53L1_timing_config_t structure
 *
 * Uses the pdev->stat_nvm.osc_measured__fast_osc__frequency convert into [us]
 *
 * @param[in]   Dev                          : Device handle
 * @param[out]  pphasecal_config_timeout_us  : current Phase Cal Timeout in [us]
 * @param[out]  pmm_config_timeout_us        : current MM Timeout in [us]
 * @param[out]  prange_config_timeout_us     : current Ranging Timeout in [us]
 *
 * @return  VL53L1_ERROR_NONE     Success
 * @return  "Other error code"    See ::VL53L1_Error
 */

VL53L1_Error VL53L1_get_timeouts_us(VL53L1_DEV Dev, uint32_t *pphasecal_config_timeout_us, uint32_t *pmm_config_timeout_us, uint32_t *prange_config_timeout_us);


/**
 * @brief  Sets the 12-bit calibration repeat period value
 *
 * Sets the repeat period for VHV and phasecal in ranges.
 * Setting to zero to disables the repeat, but the VHV
 * and PhaseCal is still run on the very first range in
 * this case.
 *
 * Only even values should be set
 *
 * The max value is 4094 i.e. every
 *
 * @param[in]   Dev                        : Device handle
 * @param[in]   cal_config__repeat_period  : current calibration config repeat period
 *
 * @return  VL53L1_ERROR_NONE     Success
 * @return  "Other error code"    See ::VL53L1_Error
 */

VL53L1_Error VL53L1_set_calibration_repeat_period(VL53L1_DEV Dev, uint16_t cal_config__repeat_period);


/**
 * @brief  Gets the current 12-bit calibration repeat period value
 *
 * @param[in]   Dev                         : Device handle
 * @param[out]  pcal_config__repeat_period  : current calibration config repeat period
 *
 * @return  VL53L1_ERROR_NONE     Success
 * @return  "Other error code"    See ::VL53L1_Error
 */

VL53L1_Error VL53L1_get_calibration_repeat_period(VL53L1_DEV Dev, uint16_t *pcal_config__repeat_period);


/**
 * @brief  Set system sequence config bit value
 *
 * @param[in]   Dev              : Device handle
 * @param[in]   bit_id           : VL53L1_DeviceSequenceConfig bit id
 * @param[in]   value            : Input Bit value = 0 or 1
 *
 * @return  VL53L1_ERROR_NONE     Success
 * @return  "Other error code"    See ::VL53L1_Error
 */

VL53L1_Error VL53L1_set_sequence_config_bit(VL53L1_DEV Dev, VL53L1_DeviceSequenceConfig bit_id, uint8_t value);


/**
 * @brief  Get system sequence config bit value
 *
 * @param[in]   Dev              : Device handle
 * @param[in]   bit_id           : VL53L1_DeviceSequenceConfig bit id
 * @param[out]  pvalue           : Output Bit value = 0 or 1
 *
 * @return  VL53L1_ERROR_NONE     Success
 * @return  "Other error code"    See ::VL53L1_Error
 */

VL53L1_Error VL53L1_get_sequence_config_bit(VL53L1_DEV Dev, VL53L1_DeviceSequenceConfig bit_id, uint8_t *pvalue);


/**
 * @brief  Set the interrupt polarity bit in
 *
 * @param[in]   Dev                 : Device handle
 * @param[in]   interrupt_polarity  : Interrupt Polarity
 *
 * @return  VL53L1_ERROR_NONE     Success
 * @return  "Other error code"    See ::VL53L1_Error
 */

VL53L1_Error VL53L1_set_interrupt_polarity(VL53L1_DEV Dev, VL53L1_DeviceInterruptPolarity interrupt_polarity);


/**
 * @brief  Get the interrupt polarity bit state
 *
 * @param[in]   Dev                  : Device handle
 * @param[out]  pinterrupt_polarity  : Interrupt Polarity Bit value
 *
 * @return  VL53L1_ERROR_NONE     Success
 * @return  "Other error code"    See ::VL53L1_Error
 */

VL53L1_Error VL53L1_get_interrupt_polarity(VL53L1_DEV Dev, VL53L1_DeviceInterruptPolarity *pinterrupt_polarity);

/**
 * @brief  Set the Ref spad char cfg struct internal to pdev
 *
 * @param[in]  Dev     : Device handle
 * @param[in]  pdata   : Input pointer to VL53L1_refspadchar_config_t
 *
 * @return  VL53L1_ERROR_NONE     Success
 * @return  "Other error code"    See ::VL53L1_Error
 */

#ifndef VL53L1_NOCALIB
VL53L1_Error VL53L1_get_refspadchar_config_struct(VL53L1_DEV Dev, VL53L1_refspadchar_config_t *pdata);
#endif

/**
 * @brief  Extract the Ref spad char cfg struct from pdev
 *
 * @param[in]  Dev     : Device handle
 * @param[out] pdata   : Output pointer to VL53L1_refspadchar_config_t
 *
 * @return  VL53L1_ERROR_NONE     Success
 * @return  "Other error code"    See ::VL53L1_Error
 */

#ifndef VL53L1_NOCALIB
VL53L1_Error VL53L1_set_refspadchar_config_struct(VL53L1_DEV Dev, VL53L1_refspadchar_config_t *pdata);
#endif

/**
 * @brief  Set the Range Ignore Threshold Rate value
 *
 * @param[in]  Dev                  : Device handle
 * @param[in]  range_ignore_thresh_mult     : Input RIT Mult value, in \
 *                                            3.5 fractional value
 * @param[in]  range_ignore_threshold_mcps  : Range Ignore Threshold value
 *
 * @return  VL53L1_ERROR_NONE     Success
 * @return  "Other error code"    See ::VL53L1_Error
 */

VL53L1_Error VL53L1_set_range_ignore_threshold(VL53L1_DEV Dev, uint8_t range_ignore_thresh_mult, uint16_t range_ignore_threshold_mcps);

/**
 * @brief  Get the Range Ignore Threshold Rate value
 *
 *
 *
 * @param[in]   Dev                  : Device handle
 * @param[out]  prange_ignore_thresh_mult              : \
 *              Range ignore threshold internal multiplier value in \
 *              3.5 fractional format.
 * @param[out]  prange_ignore_threshold_mcps_internal  : \
 *              Range Ignore Threshold Rate value generated from \
 *              current xtalk parms
 * @param[out]  prange_ignore_threshold_mcps_current   : \
 *              Range Ignore Threshold Rate value generated from \
 *              device static config struct
 *
 * @return  VL53L1_ERROR_NONE     Success
 * @return  "Other error code"    See ::VL53L1_Error
 */

VL53L1_Error VL53L1_get_range_ignore_threshold(VL53L1_DEV Dev, uint8_t *prange_ignore_thresh_mult, uint16_t *prange_ignore_threshold_mcps_internal,
											   uint16_t *prange_ignore_threshold_mcps_current);
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
