KocurMaros/MicroMouse/(commit log)

2024-01-10 PCB project
    [main_board.kicad_pcb, main_board.kicad_sch]
2024-01-10 gitignore PCB
2024-01-10 PCB prototype
    [main_board-B_Cu.gbr, main_board-B_Mask.gbr, main_board-B_Paste.gbr, main_board-B_Silkscreen.gbr, main_board-Edge_Cuts.gbr, main_board-F_Cu.gbr, main_board-F_Mask.gbr, main_board-F_Paste.gbr]
2024-01-11 atmel328p for reading ToF sensors
    [MCU.kicad_sch, main_board.kicad_pcb, main_board.kicad_sch, motors.kicad_sch, power_suply.kicad_sch, sensors.kicad_sch]
2024-01-11 second PCB
    [main_board-B_Cu.gbr, main_board-B_Mask.gbr, main_board-B_Paste.gbr, main_board-B_Silkscreen.gbr, main_board-Edge_Cuts.gbr, main_board-F_Cu.gbr, main_board-F_Mask.gbr, main_board-F_Paste.gbr]
2024-01-12 esp32 code template
2024-01-22 lost changes from old PC
    [main_board.kicad_pcb]
2024-02-06 ready for manufacture
    [main_board.kicad_pcb, main_board.kicad_sch]
2024-02-14 some changes on PCB after consultations with Mr. micromouse FEI
    [MCU.kicad_sch, main_board.kicad_pcb, main_board.kicad_sch, sensors.kicad_sch]
2024-02-28 remove atmel from code
    [main_board.kicad_pcb]
2024-02-29 remove useless files
    [main_board.kicad_pcb, motors.kicad_sch, power_pcb.kicad_pcb, power_pcb.kicad_sch, power_suply.kicad_sch]
2024-02-29 exported step of board
    [main_board.step]
2024-03-11 models for motor gear and wheel
    [motor_gear.obj, wheel_w_gear.obj]
2024-03-13 test motor driver
2024-03-16 fix: print of unsigned int
    The idf build command failes at the wrong printing command.
    [task_control.c]
2024-03-18 fix print type
2024-03-22 added folder for testing TOF sensor
2024-04-13 tof sensors working
2024-04-19 need rewrok to i2c from i2c-easy
2024-04-20 power on mpu with pin
2024-04-25 finally fixed those TOF sensors
2024-04-25 added calibration for each device
2024-05-06 driver for motor and both task cpp
2024-05-06 battery status
2024-05-10 motor: set the direction of motor motion
2024-05-10 motor_dirver: set the parameters to correct types
    [driver.c, motor_pinout.h]
2024-05-10 pid: implement PID controller
2024-05-10 pid: more conviniet way of calculation
    Use whatever function suits you better.
2024-05-11 meas_data: udpate time diff for encoder data
2024-05-11 motor_driver: calculate odometry
2024-05-12 motor_driver: calculate current speed
2024-05-13 motor_driver: clamp the pwm input
2024-05-13 control: remove encoder3 and 4
2024-05-13 calibrated gyro
2024-05-23 UDP is commented out, added a macro to convert PWM to mm/s using Fildos eqs, aand some other shit idk check the commit
2024-05-23 PID WIP, need something different
2024-05-23 Sooo, the wheel speeds were completely wrong, buut the controller still needs a lot of work
    [driver.c]
2024-05-24 stuck on pwm conversion buut after this it could be just tuning
    [driver.c, driver.h]
2024-05-25 Final 3D
    The last used revision of 3D model parts
    [1717T_SR.stp, Mount.stl, Mount.stp, Side_wall_L.stl, Side_wall_L.stp, Side_wall_R.stl, Side_wall_R.stp, main_board.stl]
2024-05-27 reugulator works, kinda, now to odometry (PAIN)
2024-05-28 print direction of motor
2024-05-28 dokumentacia + modely
    [motor_gear2.stp, wheel_w_gear_2.stp, wheel_without_gear.stp]
2024-05-28 Documentation
    CAD ad PCD doc
2024-05-28 doc motor, enkoder, džairou
2024-05-28 plotter: fix out of range access
    [mainwindow.cpp]
2024-05-28 fix: adapt the project also to linux
    [mainwindow.cpp, mainwindow.h]
2024-05-29 remove/rename var +png of tofs
    [main_board.kicad_pcb]
2024-05-29 plotter: display battery data
2024-05-29 fix gyro and 2 core support
    [main.cpp, meas_data.h, mpu9250.c, task_meas.cpp, task_udp.cpp]
2024-05-29 angles in pcb
    [main_board.kicad_pcb]
2024-05-29 ui: voltage range fix
    [mainwindow.cpp]
2024-05-29 ekes di skill issues
    [driver.c, driver.h, task_udp.cpp]
2024-05-29 ui: edit captured motor data
2024-05-29 ui: motor array size
2024-05-29 ui: fix plotting size
    [mainwindow.cpp, mainwindow.h]
2024-05-29 Reg tuned, odometry testing
2024-05-29 ui: fix crashing plotter
    [mainwindow.cpp, mainwindow.h]
2024-05-29 ui: correctly clear buffer size
    [mainwindow.cpp]
2024-05-29 pin other core
2024-05-29 ui: x axis update
2024-05-30 encoders to message
2024-05-30 ui: encoder ranges
2024-05-31 tex: correct pwm equations
2024-05-31 new version of pcb
    [MCU.kicad_sch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]
2024-07-01 step mainboard
    [main_board.step]
2024-10-18 edit board
    [main_board.kicad_pcb]
2024-11-08 step of mouse
    [main_board_v2.step]
